ooops-t/DEV-G2-NANO/(commit log)

2026-10-15 fixed schematic typo
    [user-io.kicad_sch]
2026-10-28 moved wifi module from uSDHC2 to uSDHC1
    [DEV-G2-NANO.kicad_pcb, user-io.kicad_sch]
2026-10-28 renamed RTMC Core's LSx pins
    [DEV-G2-NANO.kicad_pcb, user-io.kicad_sch]
2026-10-28 updated pin descriptions
