ooops-t/DEV-G2-NANO/(notices)

Notices in the files:
kicad/user-io.kicad_sch:
© 2026, Theta Machines LLC.
